ElectronicCats/MexaBadge/mexa_badge_defcon25.kicad_pcb

## KiCad design mexa_badge_defcon25.kicad_pcb (2017-01-12)

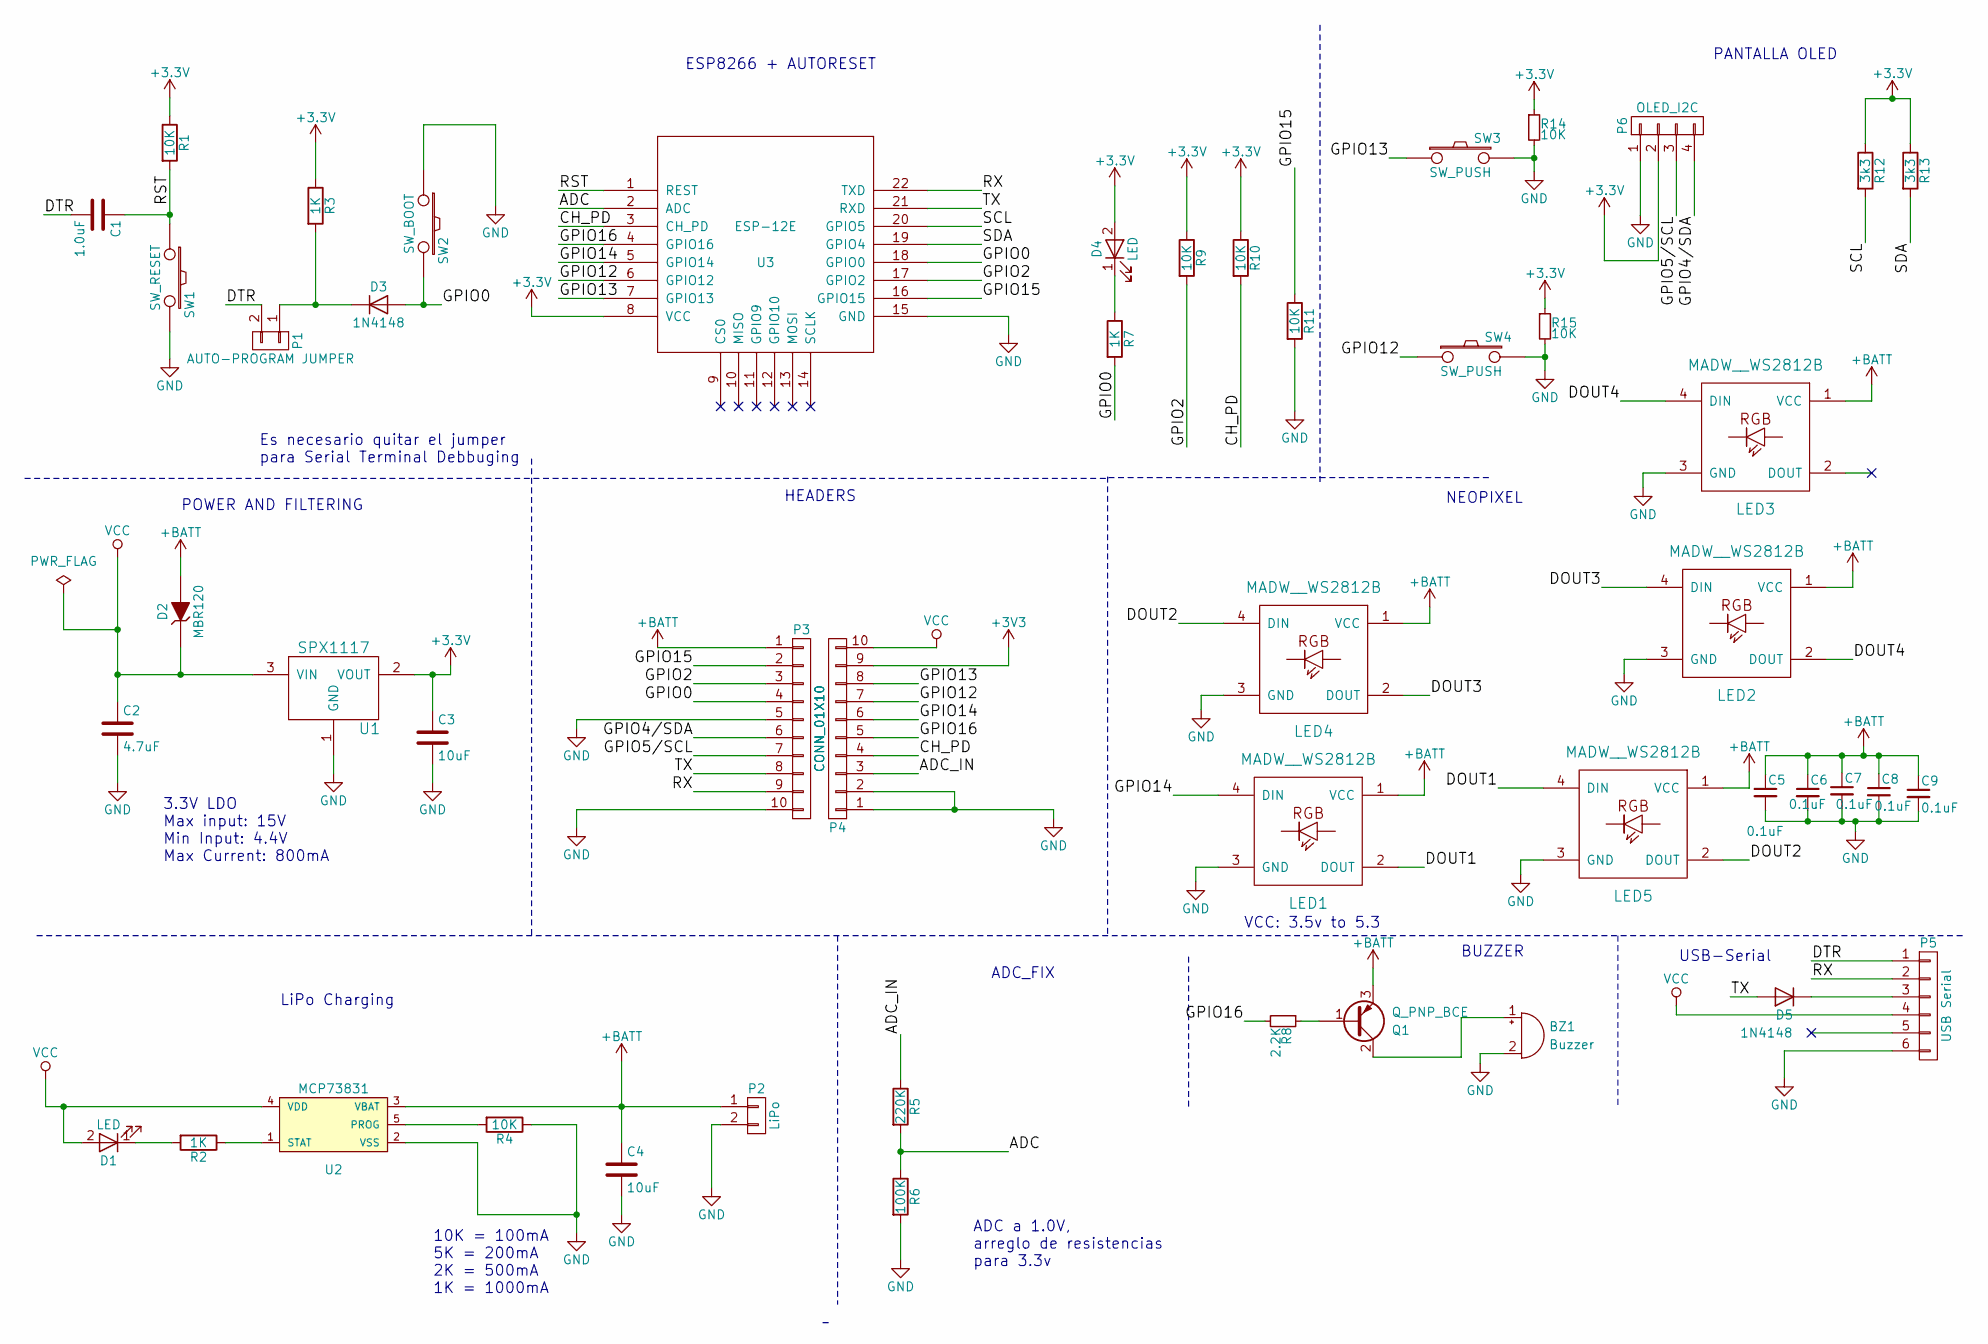
[picture p1: schematic mexa_badge_defcon25.sch, BadgeMexa]

Parts:
BZ1: Buzzer; BUZZER
C1: 1.0uF; C_0805_HandSoldering
C2: 4.7uF; C_0805_HandSoldering
C3, C4: 10uF; C_0805_HandSoldering
C5, C6, C7, C8, C9: 0.1uF; C_0805_HandSoldering
D1: LED; LED_0805
D2: MBR120; SOD-123
D3, D5: 1N4148; SOD-323
D4: LED; LED-0805
LED1, LED2, LED3, LED4, LED5: MADW__WS2812B; LED_WS2812B-PLCC4
P1: AUTO-PROGRAM JUMPER; Pin_Header_Straight_1x02
P2: LiPo; Socket_Strip_Straight_1x02
P3, P4: CONN_01X10; Socket_Strip_Straight_1x10
P5: USB Serial; Socket_Strip_Straight_1x06
P6: OLED_I2C; Socket_Strip_Straight_1x04
Q1: Q_PNP_BCE; SOT-23_Handsoldering
R1, R4, R9, R10, R11, R14, R15: 10K; R_0805_HandSoldering
R2, R3, R7: 1K; R_0805_HandSoldering
R5: 220K; R_0805_HandSoldering
R6: 100K; R_0805_HandSoldering
R8: 2.2K; R_0805_HandSoldering
R12, R13: 3k3; R_0805_HandSoldering
SW1: SW_RESET; SW_B3U-1000P
SW2: SW_BOOT; SW_B3U-1000P
SW3, SW4: SW_PUSH; SW_B3U-1000P
U1: SPX1117; SOT-223
U2: MCP73831; SOT-23-5
U3: ESP-12E

Connections:
+BATT: C4.1, C5.1, C6.1, C7.1, C8.1, C9.1, D2.2 (A), LED1.1 (VCC), LED2.1 (VCC), LED3.1 (VCC), LED4.1 (VCC), LED5.1 (VCC), P2.1, P3.1, Q1.3 (E), U2.3 (VBAT)
/ADC: R5.2, R6.1, U3.2 (ADC)
/ADC_IN: P4.3, R5.1
/CH_PD: P4.4, R10.2, U3.3 (CH_PD)
/DOUT1: LED1.2 (DOUT), LED5.4 (DIN)
/DOUT2: LED4.4 (DIN), LED5.2 (DOUT)
/DOUT3: LED2.4 (DIN), LED4.2 (DOUT)
/DOUT4: LED2.2 (DOUT), LED3.4 (DIN)
/DTR: C1.2, P1.2, P5.1
/GPIO0: D3.2 (A), P3.4, R7.2, SW2.2, U3.18 (GPIO0)
/GPIO2: P3.3, R9.2, U3.17 (GPIO2)
/GPIO4/SDA: P3.6, P6.4
/GPIO5/SCL: P3.7, P6.3
/GPIO12: P4.7, SW4.1, U3.6 (GPIO12)
/GPIO13: P4.8, SW3.1, U3.7 (GPIO13)
/GPIO14: LED1.4 (DIN), P4.6, U3.5 (GPIO14)
/GPIO15: P3.2, R11.1, U3.16 (GPIO15)
/GPIO16: P4.5, R8.2, U3.4 (GPIO16)
/RST: C1.1, R1.2, SW1.1, U3.1 (REST)
/RX: P3.9, P5.2, U3.22 (TXD)
/SCL: R12.2, U3.20 (GPIO5)
/SDA: R13.2, U3.19 (GPIO4)
/TX: D5.2 (A), P3.8, U3.21 (RXD)
GND: BZ1.2 (+), C2.2, C3.2, C4.2, C5.2, C6.2, C7.2, C8.2, C9.2, LED1.3 (GND), LED2.3 (GND), LED3.3 (GND), LED4.3 (GND), LED5.3 (GND), P2.2, P3.5, P3.10, P4.1, P4.2, P5.6, P6.1, R4.1, R6.2, R11.2, R14.2, R15.2, SW1.2, SW2.1, SW3.2, SW4.2, U1.1 (GND), U2.2 (VSS), U3.15 (GND)
unnamed: BZ1.1 (-), Q1.2 (C)
unnamed: D1.1 (K), R2.2
unnamed: D3.1 (K), P1.1, R3.2
unnamed: D4.1 (K), R7.1
unnamed: D5.1 (K), P5.3
unnamed: Q1.1 (B), R8.1
unnamed: R2.1, U2.1 (STAT)
unnamed: R4.2, U2.5 (PROG)
VCC: C2.1, D1.2 (A), D2.1 (K), P4.10, P5.4, U1.3 (VIN), U2.4 (VDD)

Notes on the sheet:
10K = 100mA 5K = 200mA 2K = 500mA 1K = 1000mA
LiPo Charging
POWER AND FILTERING
ESP8266 + AUTORESET
PANTALLA OLED
Es necesario quitar el jumper para Serial Terminal Debbuging
NEOPIXEL
USB-Serial
HEADERS
ADC_FIX
ADC a 1.0V, arreglo de resistencias para 3.3v
3.3V LDO Max input: 15V Min Input: 4.4V Max Current: 800mA
VCC: 3.5v to 5.3
BUZZER

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
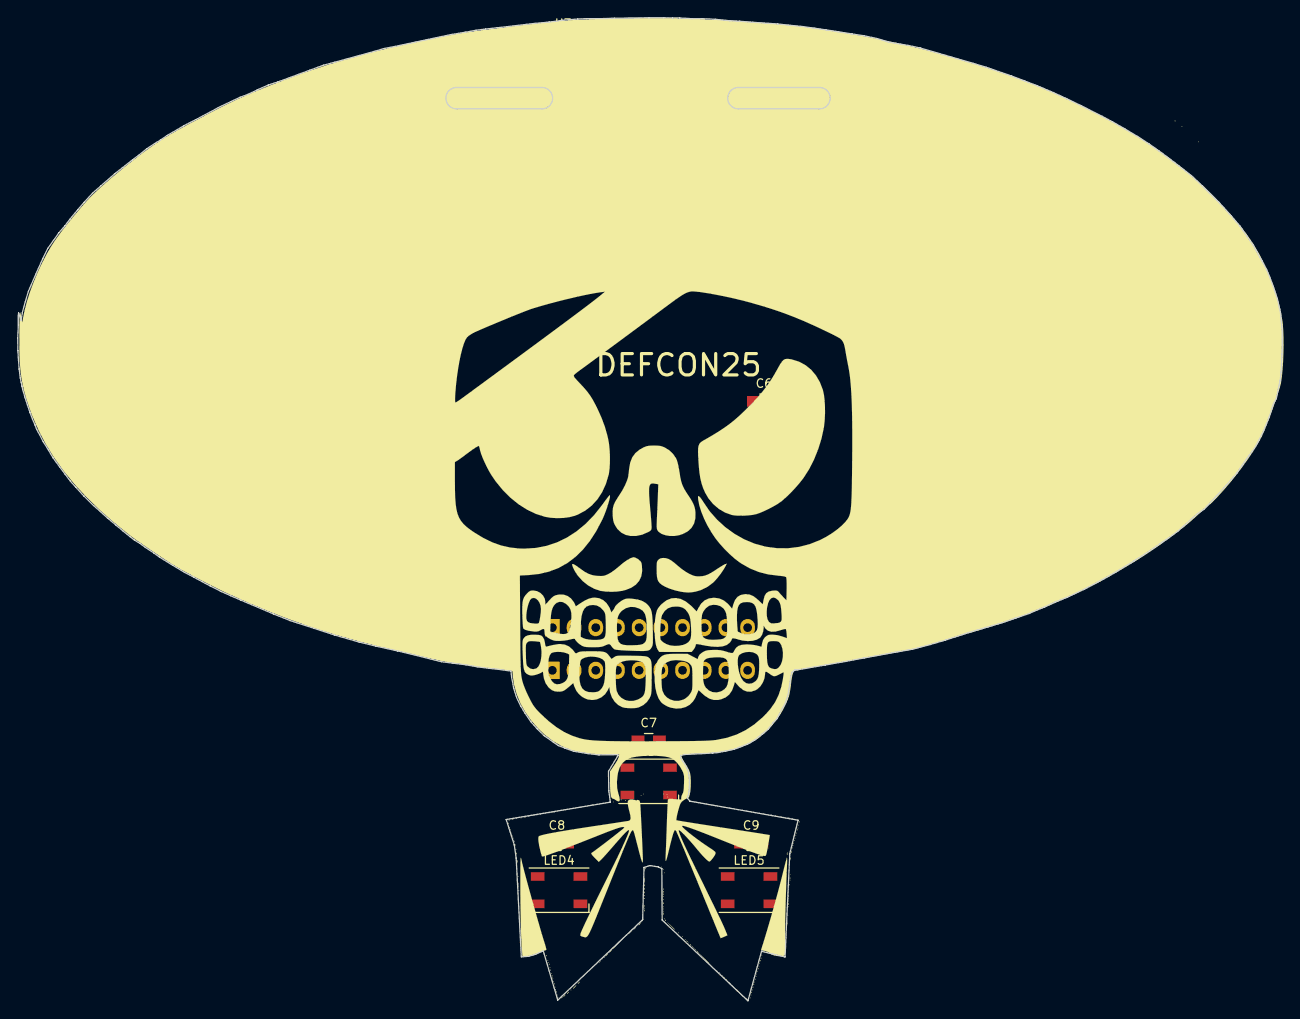
[picture p2: board mexa_badge_defcon25.kicad_pcb from above]

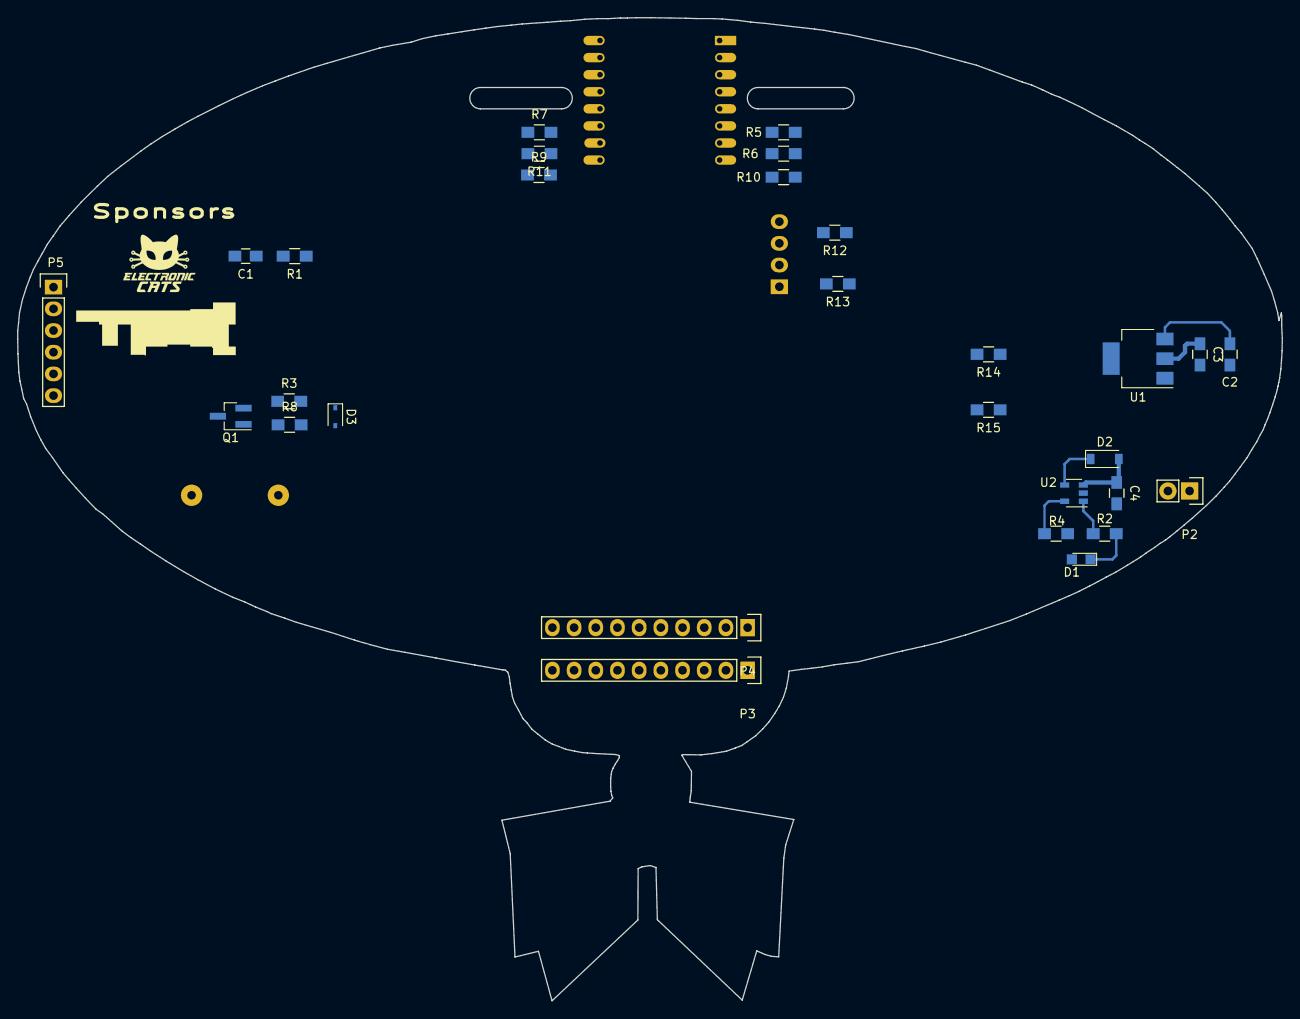
[picture p3: board mexa_badge_defcon25.kicad_pcb from below]

Board: 2 copper layers, 148.1 x 115.1 mm, 47 parts (29 on the bottom side), 33 nets.
