ElectronicCats/MexaBadge/Firmware/src/main.cpp

#include <Arduino.h>
#include <Ticker.h>
#include <Wire.h>

#include "AnalogInput.h"
#include "Button.h"
#include "ConnectProcess.h"
#include "ESP8266WiFi.h"
#include "OccupationProcess.h"
#include "SSD1306.h"
#include "ScanHostsProcess.h"
#include "ScanProcess.h"
#include <painlessMesh.h>
#include <NeoPixelBus.h>

// Include custom images
#include "images.h"

#include "Pinger.h"
// include pin definitions
#include "defs.h"

//const uint16_t PixelCount = 4; // this example assumes 4 pixels, making it smaller will cause a failure
//const uint8_t PixelPin = 10;  // make sure to set this to the correct pin, ignored for Esp8266

//#define colorSaturation 128

// The bitbang method is really only good if you are not using WiFi features of the ESP
// It works with all but pin 16
//NeoPixelBus<NeoGrbFeature, NeoEsp8266BitBang800KbpsMethod> strip(PixelCount, PixelPin);
//NeoPixelBus<NeoRgbFeature, NeoEsp8266BitBang400KbpsMethod> strip(PixelCount, PixelPin);

SSD1306 display(0x3C, 4, 5);
AnalogInput batteryVoltage(VBAT_PIN, VBAT_MAX / ADC_MAX, 10);
Button down(12, true, true);
Button up(13, true, true);
Button left(14, true, true, true);
Ticker buttonUpdater;

ScanProcess scanner(&display);
Process *currentProcess = &scanner;

void updateButton() {
  down.update();
  up.update();
  left.update();
}

void drawStatusBar() {
  // draw the battery indicator and voltage
  float currentVoltage = batteryVoltage.readConverted();
  int screenWidthLeft = DISPLAY_WIDTH;

  const char *currentVoltageImage = NULL;
  if (currentVoltage >= 3.6) {
    currentVoltageImage = icon_battery_33;
  } else if (currentVoltage >= 3.4) {
    currentVoltageImage = icon_battery_23;
  } else if (currentVoltage >= 3.2) {
    currentVoltageImage = icon_battery_13;
  } else {
    currentVoltageImage = icon_battery_03;
  }

  display.drawXbm(DISPLAY_WIDTH - ICON_BATTERY_WIDTH, 2, ICON_BATTERY_WIDTH,
                  ICON_BATTERY_HEIGHT, currentVoltageImage);

  screenWidthLeft -= ICON_BATTERY_WIDTH + 2;

  display.setTextAlignment(TEXT_ALIGN_RIGHT);
  display.setFont(ArialMT_Plain_10);
  String voltageText = String(currentVoltage, 2) + "V";
  display.drawString(screenWidthLeft, 0, voltageText);
  display.drawLine(0, 11, DISPLAY_WIDTH, 11);

  screenWidthLeft -= display.getStringWidth(voltageText) + 4;

  // draw the sdcard icon if a card is present
  display.drawXbm(screenWidthLeft - ICON_SDCARD_WIDTH, 2, ICON_SDCARD_WIDTH,
                  ICON_SDCARD_HEIGHT, icon_sdcard);

  screenWidthLeft -= ICON_SDCARD_WIDTH + 4;

  // draw the wifi icon if connected
  if (WiFi.status() == WL_CONNECTED) {
    display.drawXbm(screenWidthLeft - ICON_WIFI_WIDTH, 2, ICON_WIFI_WIDTH,
                    ICON_WIFI_HEIGHT, icon_wifi);

    screenWidthLeft -= ICON_WIFI_WIDTH + 4;
  }

  // draw the current menu location
  String currentScreenName = currentProcess->getName();
  while (display.getStringWidth(currentScreenName) > screenWidthLeft) {
    currentScreenName.remove(currentScreenName.length() - 4);
    currentScreenName += "...";
  }

  display.setTextAlignment(TEXT_ALIGN_LEFT);
  display.drawString(0, 0, currentScreenName);
}

void setup() {
  display.init();

  display.flipScreenVertically();

  pinMode(VBAT_PIN, INPUT);

  Serial.begin(115200);
  Serial.println("lalalalala test");

  buttonUpdater.attach_ms(10, updateButton);

  currentProcess->initialize();

  scanner.setCallback([currentProcess](int selectedLan) {
    currentProcess = new ConnectProcess(&display, selectedLan);
    currentProcess->setCallback([currentProcess](int status) {
      if (status == 0) {
        currentProcess = new ScanHostsProcess(&display);
        currentProcess->initialize();
      } else {
        currentProcess = &scanner;
      }
    });
  });
}

void handleInput() {
  status_t status = up.getStatus();
  currentProcess->handleInput(Up, status);

  status = down.getStatus();
  currentProcess->handleInput(Down, status);

  status = left.getStatus();
  currentProcess->handleInput(Left, status);
}

void loop() {
  display.clear();
  drawStatusBar();

  currentProcess->update();

  handleInput();

  display.display();
}
