ElectronicCats/MexaBadge/Firmware/src/images.h

#define ICON_BATTERY_WIDTH 16
#define ICON_BATTERY_HEIGHT 8

const char icon_battery_33[] PROGMEM = {0xfe, 0xff, 0x02, 0x80, 0xbb, 0xbb,
                                        0xb9, 0xbb, 0xb9, 0xbb, 0xbb, 0xbb,
                                        0x02, 0x80, 0xfe, 0xff};
const char icon_battery_23[] PROGMEM = {0xfe, 0xff, 0x02, 0x80, 0x83, 0xbb,
                                        0x81, 0xbb, 0x81, 0xbb, 0x83, 0xbb,
                                        0x02, 0x80, 0xfe, 0xff};
const char icon_battery_13[] PROGMEM = {0xfe, 0xff, 0x02, 0x80, 0x03, 0xb8,
                                        0x01, 0xb8, 0x01, 0xb8, 0x03, 0xb8,
                                        0x02, 0x80, 0xfe, 0xff};
const char icon_battery_03[] PROGMEM = {0xfe, 0xff, 0x02, 0x80, 0x03, 0x80,
                                        0x01, 0x80, 0x01, 0x80, 0x03, 0x80,
                                        0x02, 0x80, 0xfe, 0xff};

#define ICON_SDCARD_WIDTH 8
#define ICON_SDCARD_HEIGHT 8
const char icon_sdcard[] PROGMEM = {0x7f, 0x55, 0x55, 0x81,
                                    0x81, 0x81, 0x81, 0xff};

#define ICON_WIFI_WIDTH 8
#define ICON_WIFI_HEIGHT 8
const char icon_wifi[] PROGMEM = {0x3c, 0x42, 0x81, 0x3c,
                                  0x42, 0x00, 0x18, 0x00};
