ElectronicCats/MexaBadge/(commit log)

2017-01-03 Add desing
    [mexa_badge_defcon25.kicad_pcb, mexa_badge_defcon25.sch]
2017-01-03 Add Sponsors
    [mexa_badge_defcon25.kicad_pcb]
2017-01-03 Add Schematic
    [mexa_badge_defcon25.sch]
2017-01-03 Update data
    [mexa_badge_defcon25.sch]
2017-01-03 version 0.1
    [mexa_badge_defcon25.sch]
2017-01-04 Change SDA and SCL
    [mexa_badge_defcon25.sch]
2017-01-04 Init PCB
    [mexa_badge_defcon25.kicad_pcb]
2017-01-04 Pre acomodo
    [mexa_badge_defcon25.kicad_pcb]
2017-01-12 fix ways
    [mexa_badge_defcon25.kicad_pcb]
